KungAlpaca/HomeMadeUR10Gripper/docs/images/v2_iso_closed.png

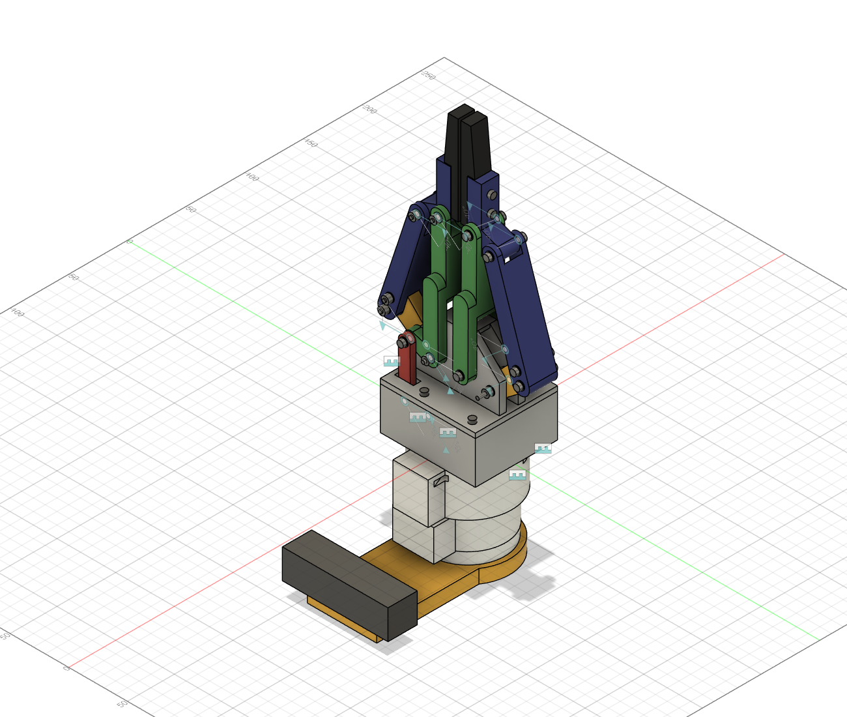
docs/images/v2_iso_closed.png
