KungAlpaca/HomeMadeUR10Gripper/docs/images/v2_iso_open.png

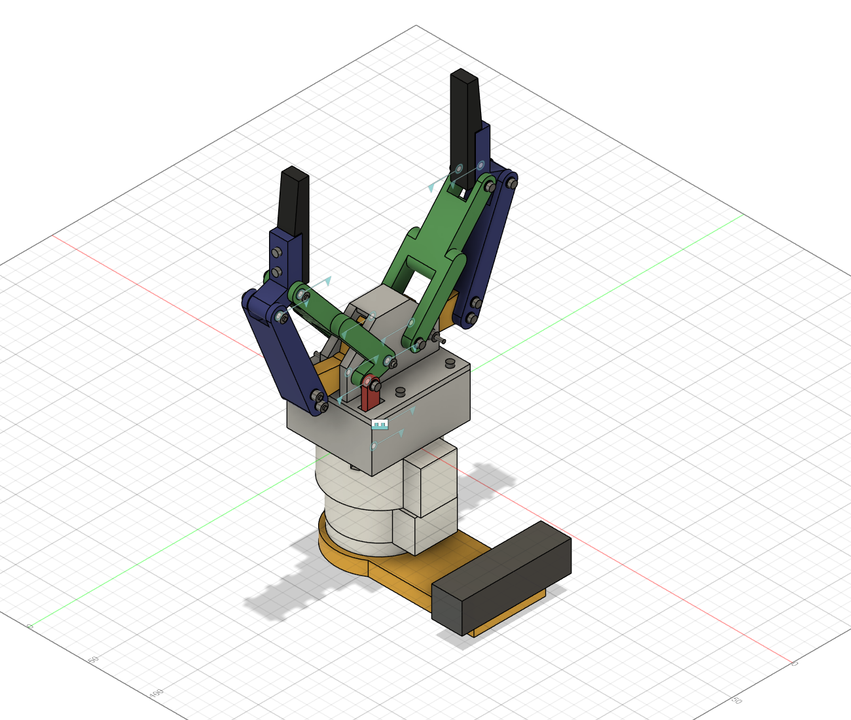
docs/images/v2_iso_open.png
