KungAlpaca/HomeMadeUR10Gripper/cad/HomeMade2F140_v2_assembly.step

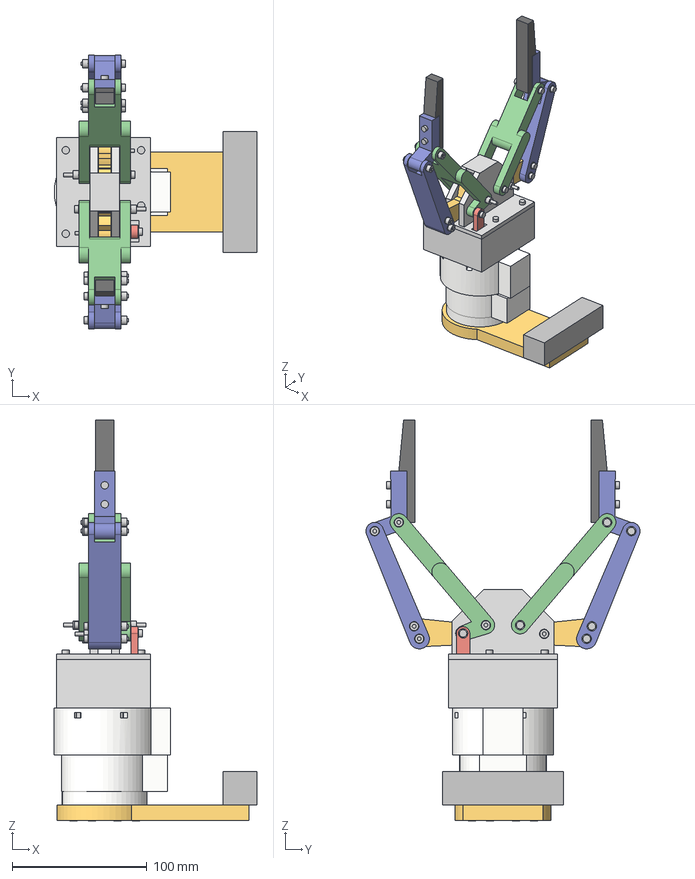
[picture p5: CAD file, 2026-10-15]
cad/HomeMade2F140_v2_assembly.step
150.3 x 203.5 x 297.7 mm
