KungAlpaca/HomeMadeUR10Gripper/print/parts/HomeMade2F140_SpacerB_x1.stl

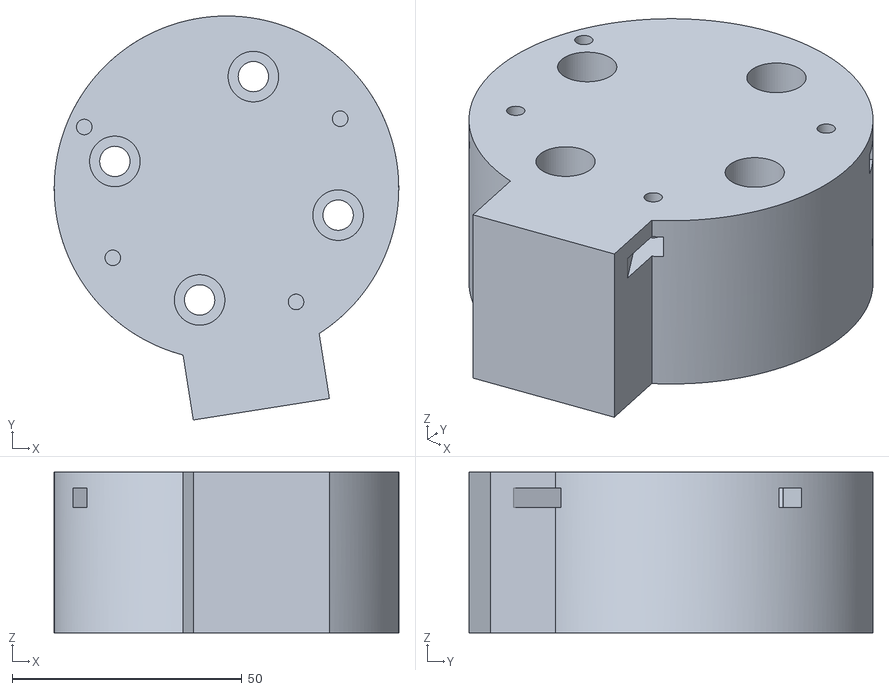
[picture p6: CAD file, 2026-10-15]
print/parts/HomeMade2F140_SpacerB_x1.stl
75.0 x 87.9 x 35.0
