KungAlpaca/HomeMadeUR10Gripper/print/plates/HomeMade2F140_plate1_250x250.stl

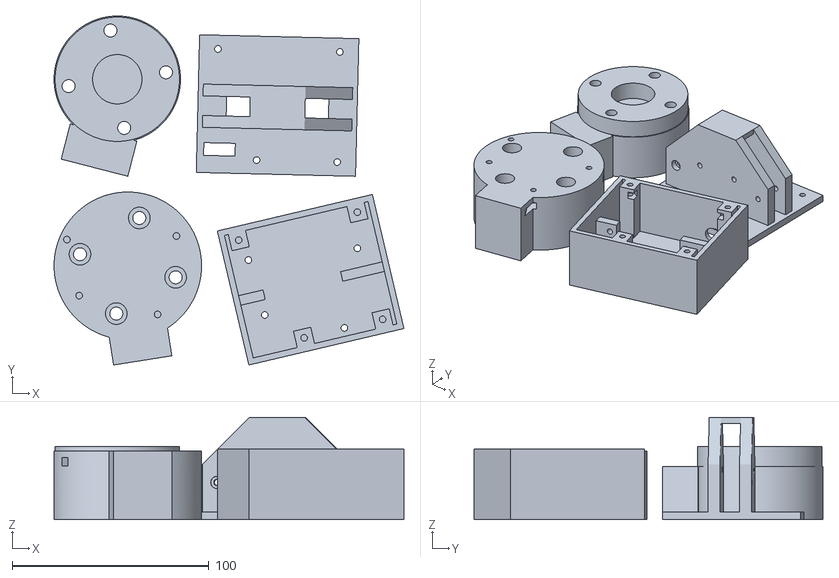
[picture p7: CAD file, 2026-10-15]
print/plates/HomeMade2F140_plate1_250x250.stl
177.9 x 177.4 x 52.0
