KungAlpaca/HomeMadeUR10Gripper/scripts/raw/SpacerB.stl

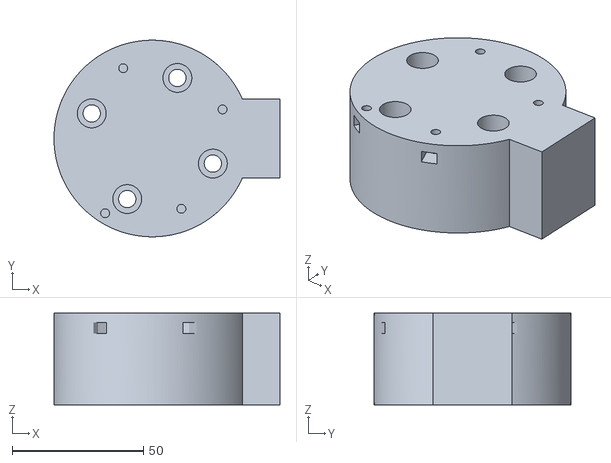
[picture p8: CAD file, 2026-10-15]
scripts/raw/SpacerB.stl
86.2 x 75.0 x 35.0
