KungAlpaca/HomeMadeUR10Gripper/print/parts/HomeMade2F140_Fingertip_x2.stl

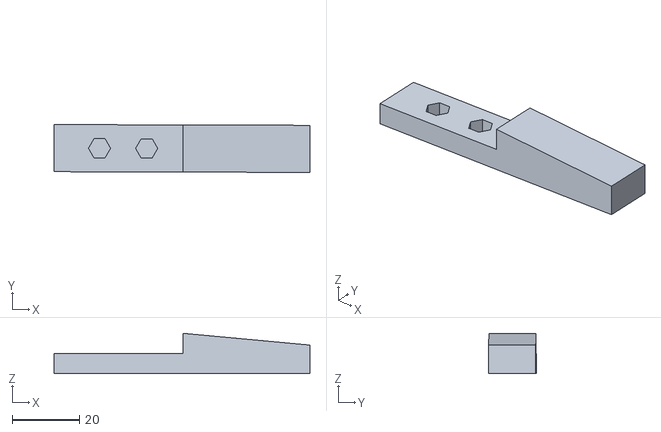
[picture p9: CAD file, 2026-10-15]
print/parts/HomeMade2F140_Fingertip_x2.stl
76.0 x 14.2 x 12.0
