KungAlpaca/HomeMadeUR10Gripper/print/plates/HomeMade2F140_print_set_17pcs.stl

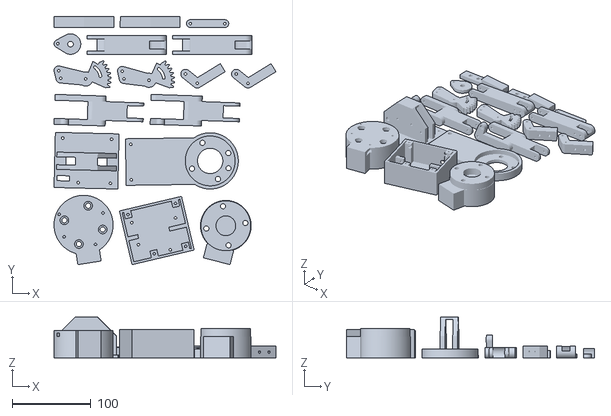
[picture p10: CAD file, 2026-10-15]
print/plates/HomeMade2F140_print_set_17pcs.stl
281.7 x 315.1 x 52.0
