KungAlpaca/HomeMadeUR10Gripper/scripts/raw/Crank.stl

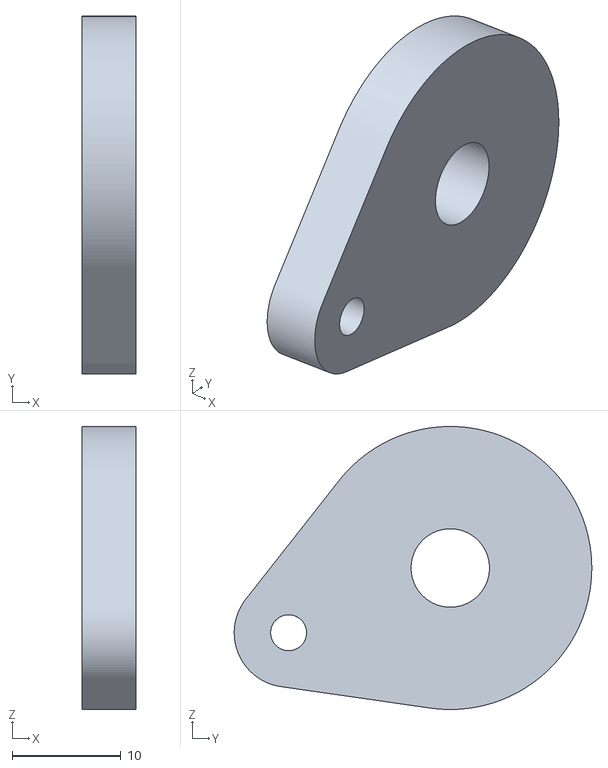
[picture p11: CAD file, 2026-10-15]
scripts/raw/Crank.stl
5.00 x 32.9 x 26.0
