KungAlpaca/HomeMadeUR10Gripper/print/parts/HomeMade2F140_CameraMount_x1.stl

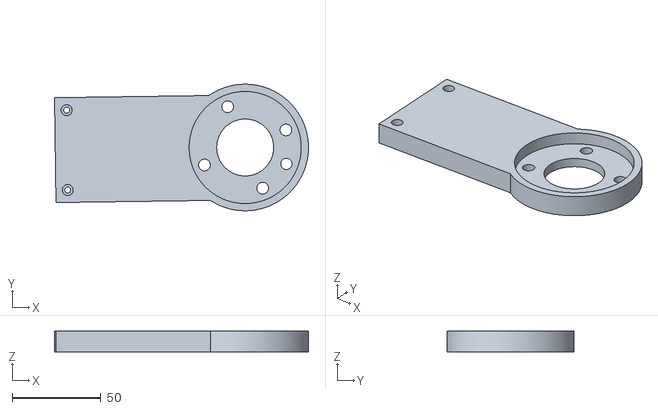
[picture p12: CAD file, 2026-10-15]
print/parts/HomeMade2F140_CameraMount_x1.stl
143.2 x 71.4 x 11.6
