KungAlpaca/HomeMadeUR10Gripper/print/plates/HomeMade2F140_plate2_250x250.stl

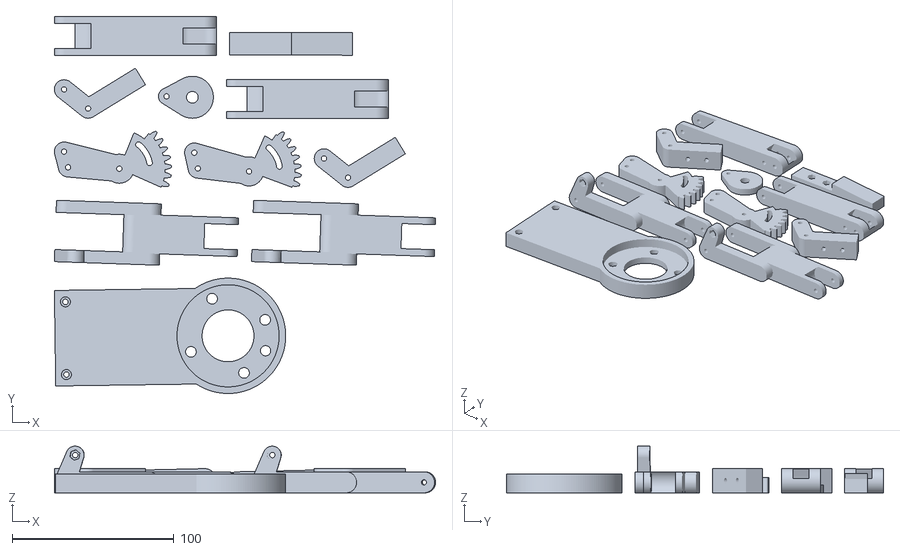
[picture p13: CAD file, 2026-10-15]
print/plates/HomeMade2F140_plate2_250x250.stl
236.0 x 233.3 x 28.9
