KungAlpaca/HomeMadeUR10Gripper/print/parts/HomeMade2F140_OuterFinger_x2.stl

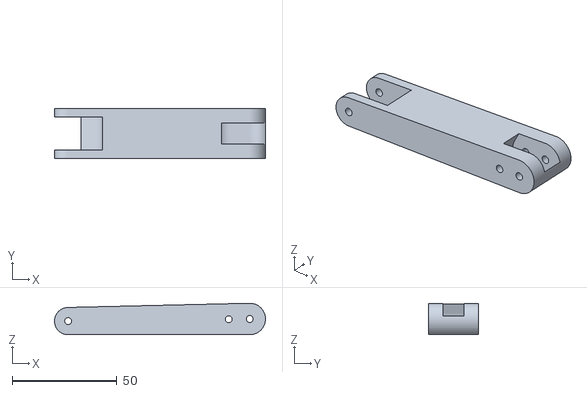
[picture p14: CAD file, 2026-10-15]
print/parts/HomeMade2F140_OuterFinger_x2.stl
100.5 x 24.0 x 15.0
