KungAlpaca/HomeMadeUR10Gripper/print/plates/HomeMade2F140_plate3_250x250.stl

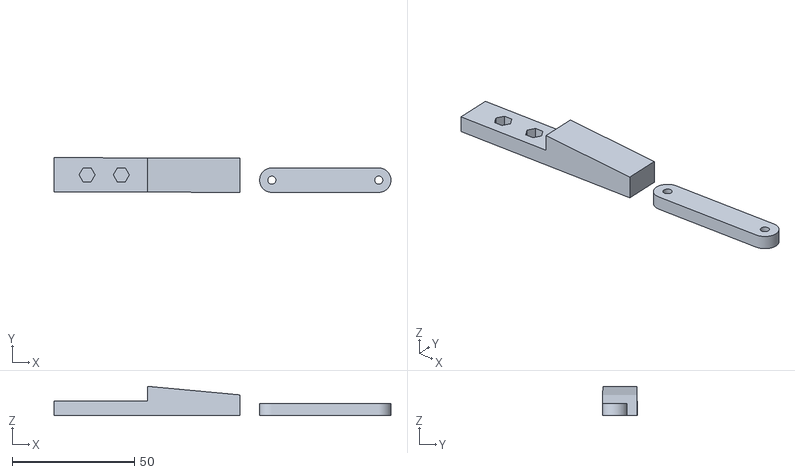
[picture p15: CAD file, 2026-10-15]
print/plates/HomeMade2F140_plate3_250x250.stl
137.8 x 14.2 x 12.0
