KungAlpaca/HomeMadeUR10Gripper/scripts/raw/SpacerA.stl

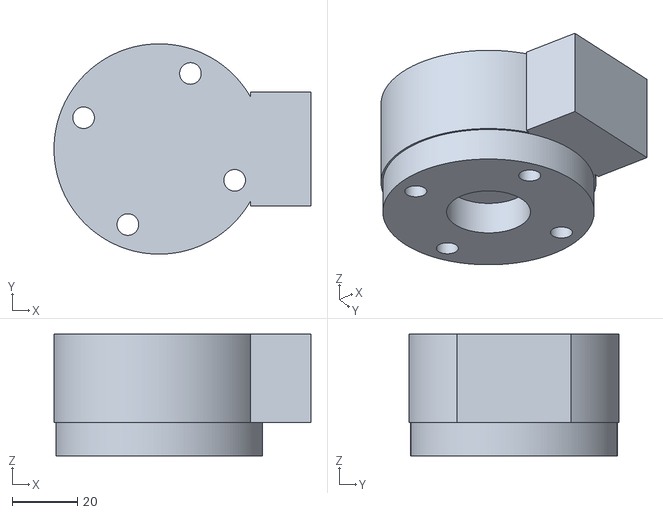
[picture p16: CAD file, 2026-10-15]
scripts/raw/SpacerA.stl
78.6 x 64.3 x 37.2
