KungAlpaca/HomeMadeUR10Gripper/print/parts/HomeMade2F140_SpacerA_x1.stl

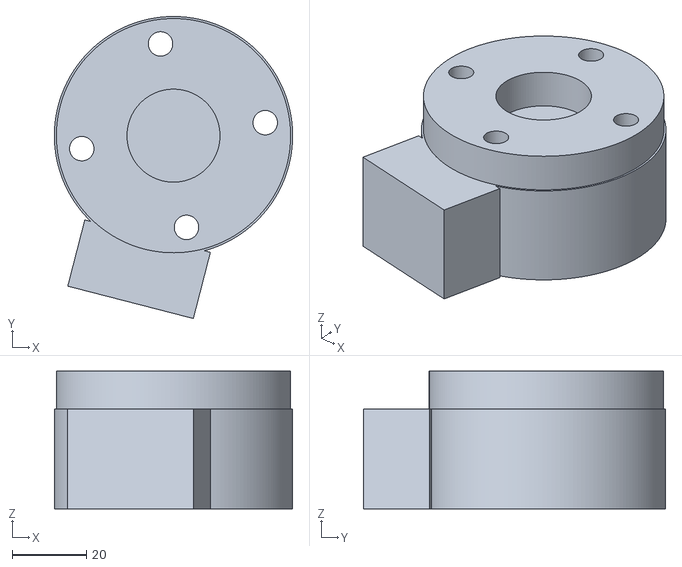
[picture p17: CAD file, 2026-10-15]
print/parts/HomeMade2F140_SpacerA_x1.stl
64.3 x 81.5 x 37.2
