KungAlpaca/HomeMadeUR10Gripper/scripts/raw/OuterKnuckle_L.stl

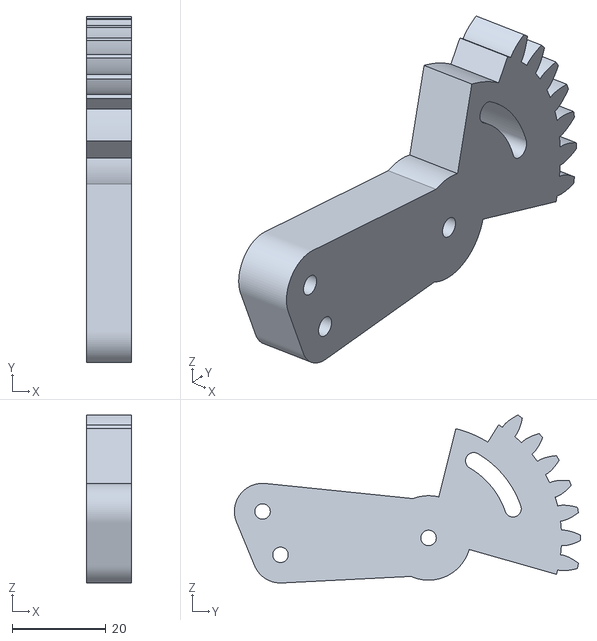
[picture p18: CAD file, 2026-10-15]
scripts/raw/OuterKnuckle_L.stl
9.50 x 73.8 x 35.8
