KungAlpaca/HomeMadeUR10Gripper/print/parts/HomeMade2F140_OuterKnuckle_R_x1.stl

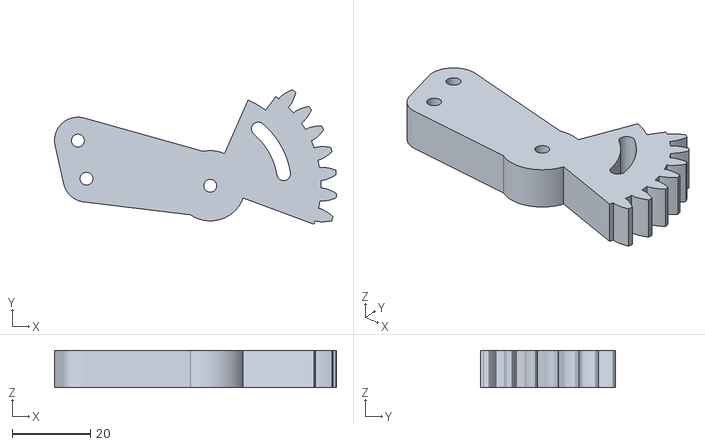
[picture p19: CAD file, 2026-10-15]
print/parts/HomeMade2F140_OuterKnuckle_R_x1.stl
72.2 x 34.5 x 9.50
