KungAlpaca/HomeMadeUR10Gripper/scripts/raw/HousingBox.stl

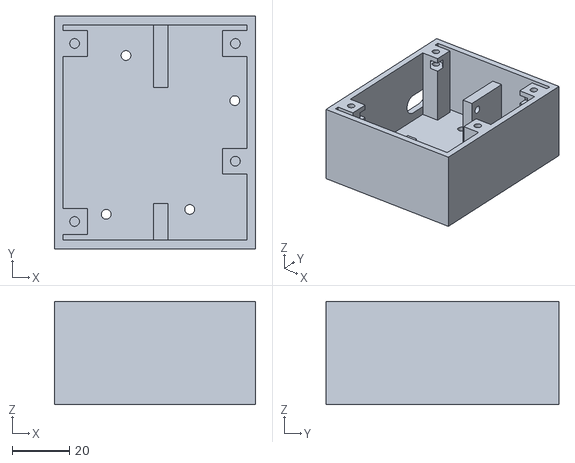
[picture p20: CAD file, 2026-10-15]
scripts/raw/HousingBox.stl
70.0 x 81.0 x 36.0
