KungAlpaca/HomeMadeUR10Gripper/print/parts/HomeMade2F140_Rod_x1.stl

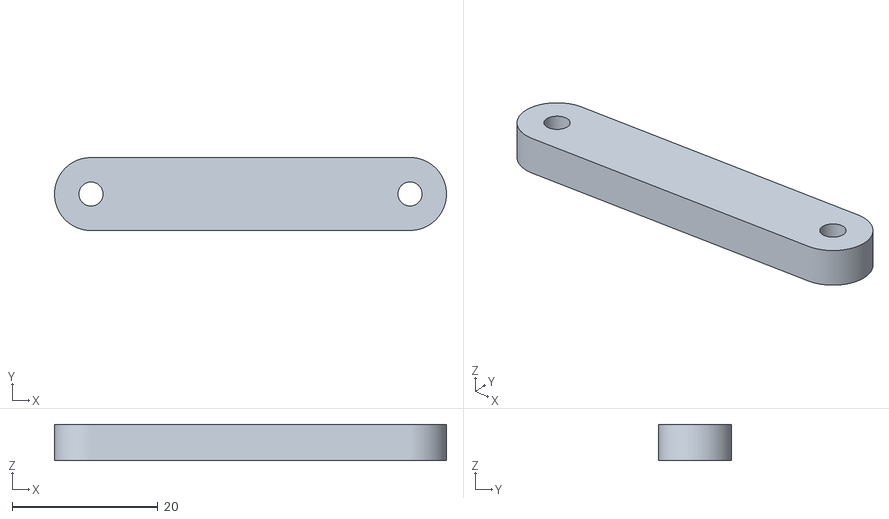
[picture p21: CAD file, 2026-10-15]
print/parts/HomeMade2F140_Rod_x1.stl
53.7 x 10.0 x 5.00
