KungAlpaca/HomeMadeUR10Gripper/scripts/raw/Servo_D5545GS.stl

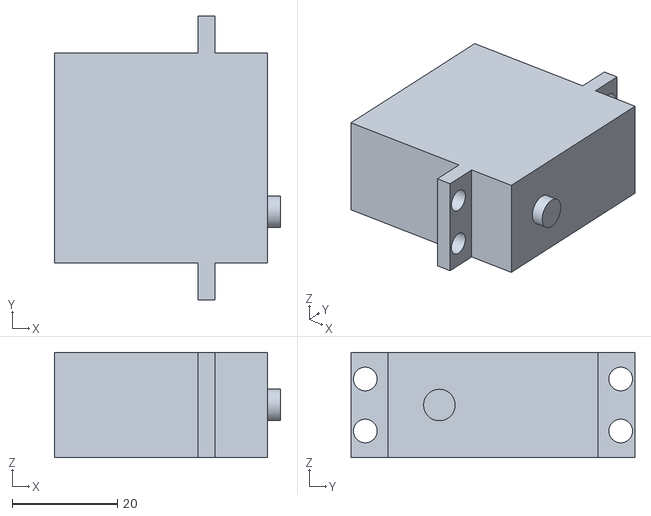
[picture p22: CAD file, 2026-10-15]
scripts/raw/Servo_D5545GS.stl
43.0 x 54.0 x 20.0
