KungAlpaca/HomeMadeUR10Gripper/print/parts/HomeMade2F140_InnerFinger_x2.stl

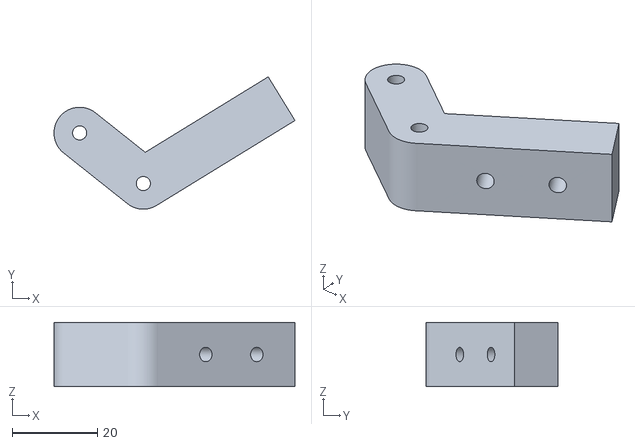
[picture p23: CAD file, 2026-10-15]
print/parts/HomeMade2F140_InnerFinger_x2.stl
56.4 x 31.0 x 15.0
