KungAlpaca/HomeMadeUR10Gripper/scripts/raw/InnerFinger.stl

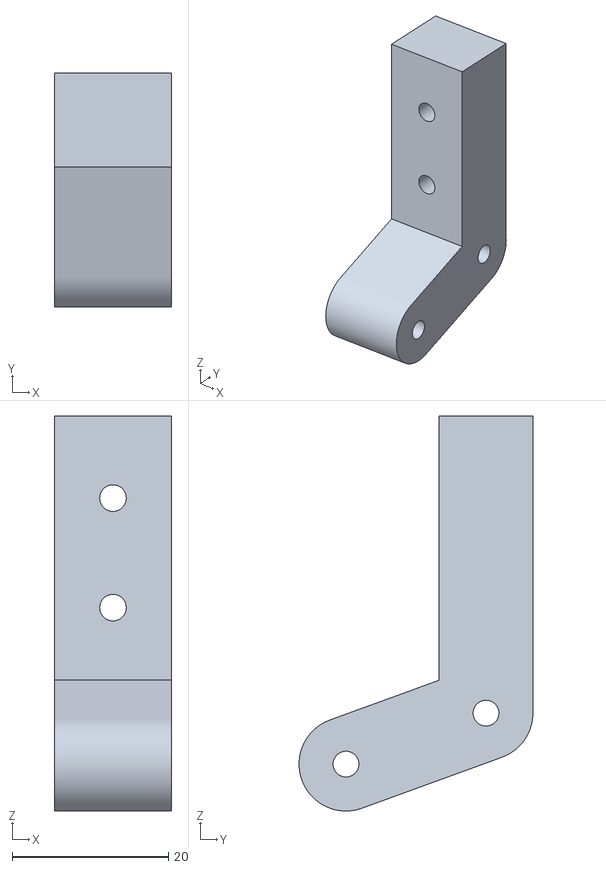
[picture p24: CAD file, 2026-10-15]
scripts/raw/InnerFinger.stl
15.0 x 29.9 x 50.5
