KungAlpaca/HomeMadeUR10Gripper/print/parts/HomeMade2F140_OuterKnuckle_L_x1.stl

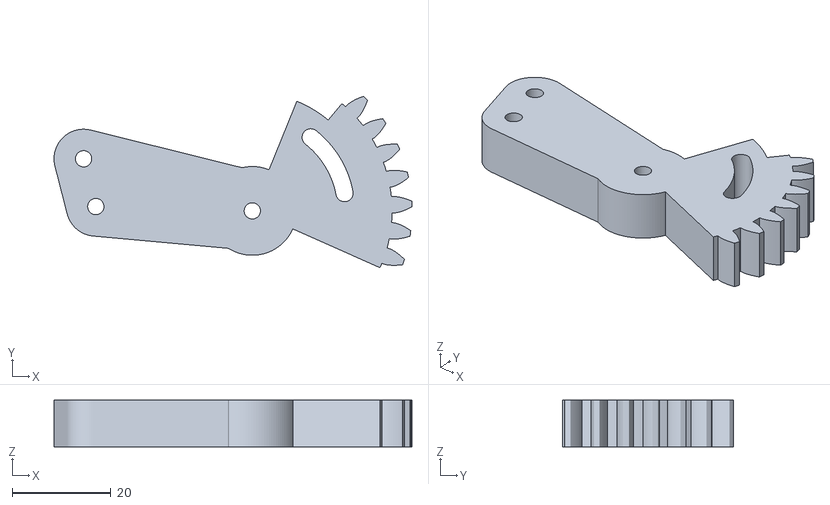
[picture p25: CAD file, 2026-10-15]
print/parts/HomeMade2F140_OuterKnuckle_L_x1.stl
72.6 x 34.8 x 9.50
