KungAlpaca/HomeMadeUR10Gripper/scripts/raw/OuterFinger.stl

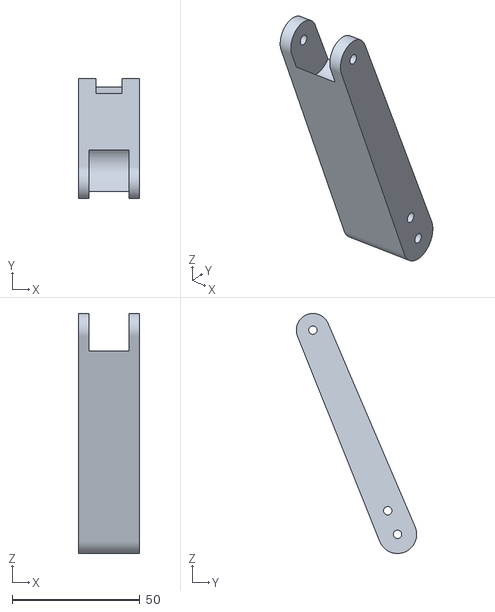
[picture p26: CAD file, 2026-10-15]
scripts/raw/OuterFinger.stl
24.0 x 47.1 x 93.9
