KungAlpaca/HomeMadeUR10Gripper/print/parts/HomeMade2F140_HousingBox_x1.stl

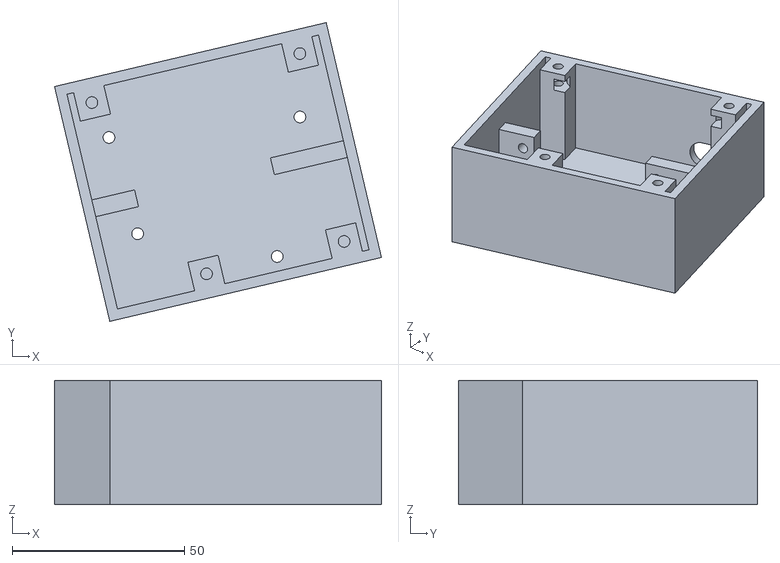
[picture p27: CAD file, 2026-10-15]
print/parts/HomeMade2F140_HousingBox_x1.stl
94.9 x 86.7 x 36.0
