KungAlpaca/HomeMadeUR10Gripper/print/parts/HomeMade2F140_Crank_x1.stl

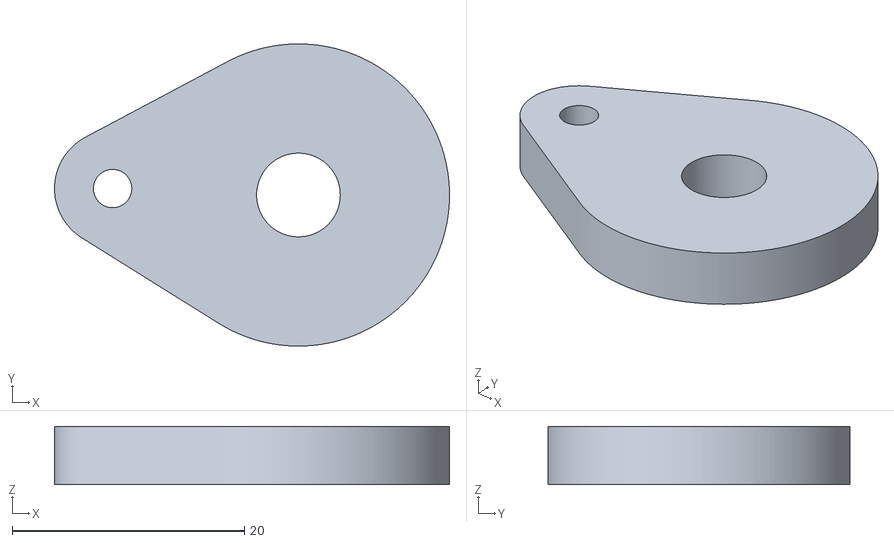
[picture p28: CAD file, 2026-10-15]
print/parts/HomeMade2F140_Crank_x1.stl
34.0 x 26.0 x 5.00
