KungAlpaca/HomeMadeUR10Gripper/print/parts/HomeMade2F140_Tower_x1.stl

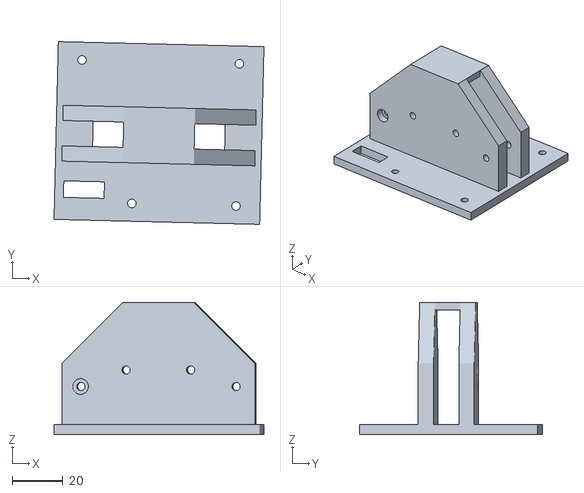
[picture p29: CAD file, 2026-10-15]
print/parts/HomeMade2F140_Tower_x1.stl
82.7 x 71.9 x 52.0
