KungAlpaca/HomeMadeUR10Gripper/scripts/raw/OuterKnuckle_R.stl

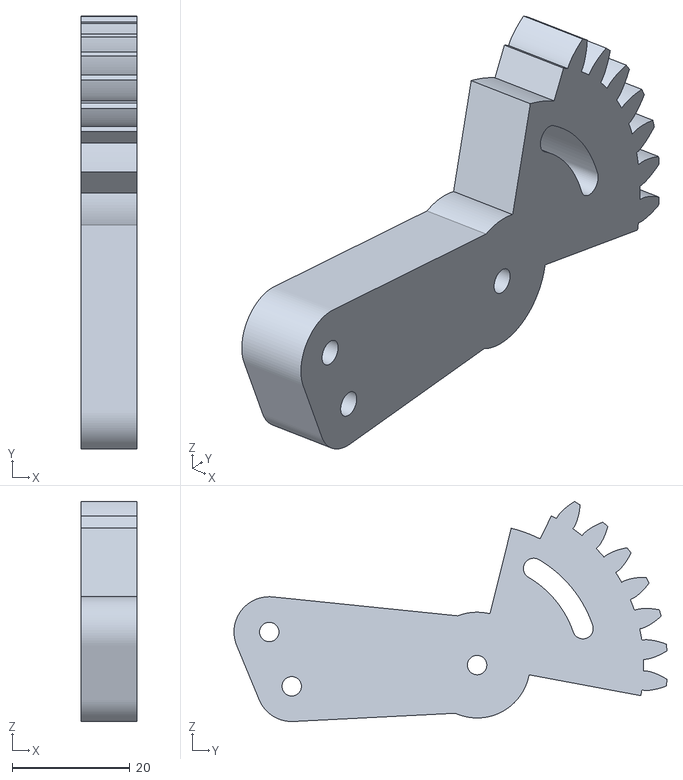
[picture p30: CAD file, 2026-10-15]
scripts/raw/OuterKnuckle_R.stl
9.50 x 73.7 x 37.4
