KungAlpaca/HomeMadeUR10Gripper/print/parts/HomeMade2F140_InnerKnuckle_x2.stl

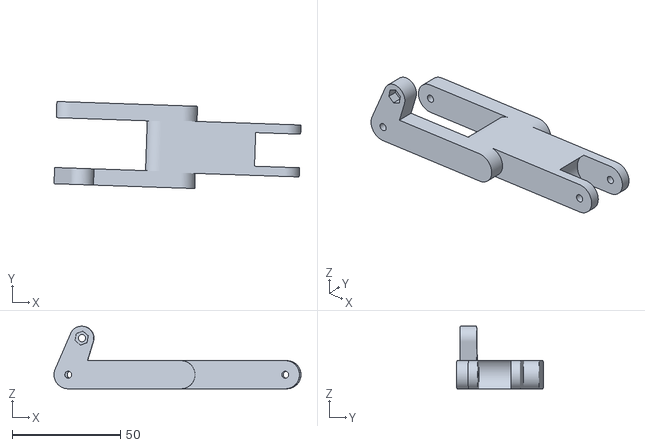
[picture p31: CAD file, 2026-10-15]
print/parts/HomeMade2F140_InnerKnuckle_x2.stl
114.0 x 40.2 x 28.9
