KungAlpaca/HomeMadeUR10Gripper/scripts/raw/Tower.stl

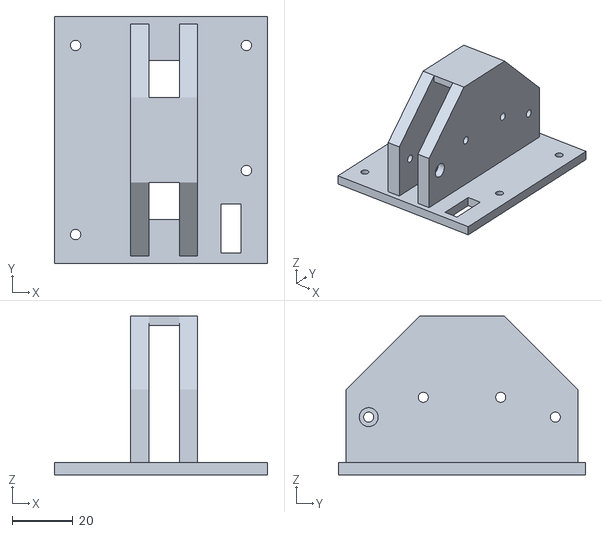
[picture p32: CAD file, 2026-10-15]
scripts/raw/Tower.stl
70.0 x 81.0 x 52.0
