KungAlpaca/HomeMadeUR10Gripper/scripts/raw/InnerKnuckle.stl

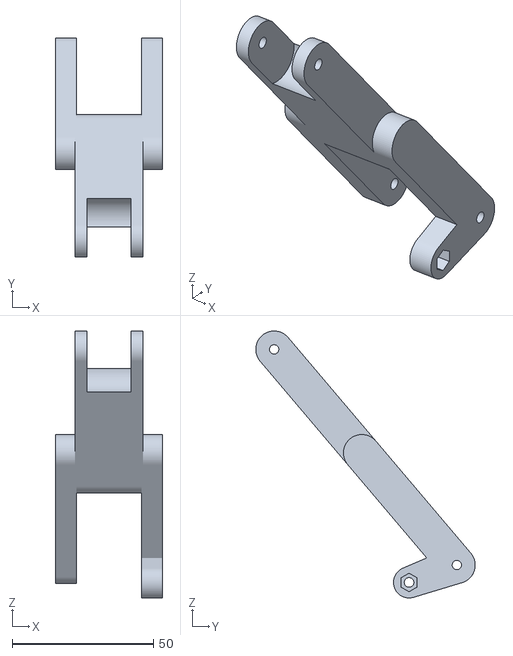
[picture p33: CAD file, 2026-10-15]
scripts/raw/InnerKnuckle.stl
38.0 x 77.6 x 94.5
