KungAlpaca/HomeMadeUR10Gripper/scripts/raw/RealSense_D435i_Ref.stl

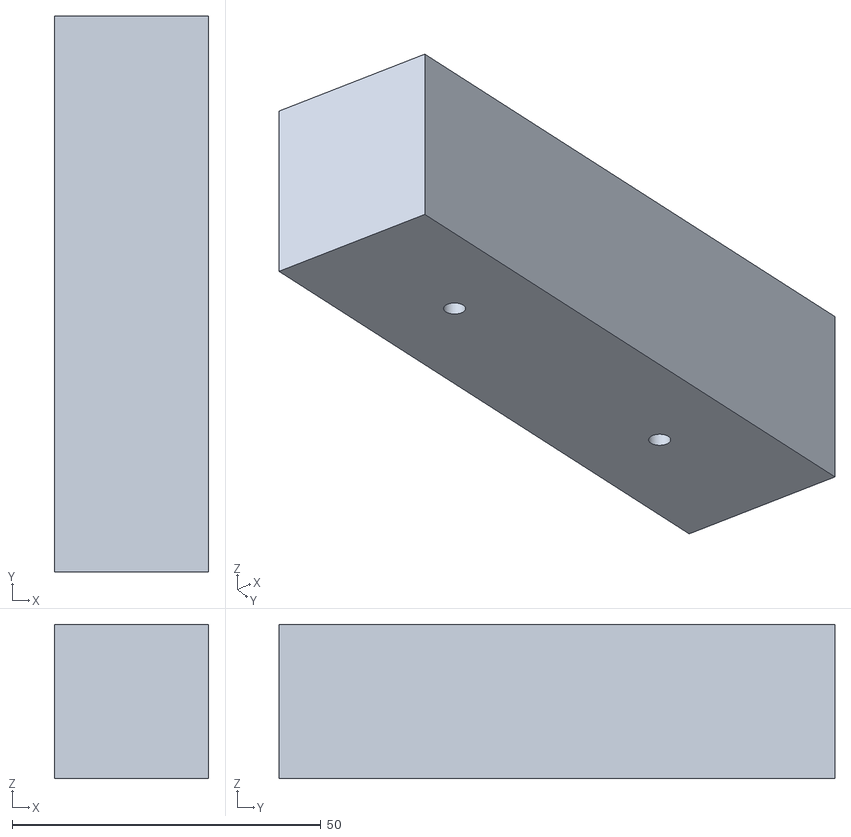
[picture p34: CAD file, 2026-10-15]
scripts/raw/RealSense_D435i_Ref.stl
25.0 x 90.0 x 25.0
