KungAlpaca/HomeMadeUR10Gripper/scripts/raw/ServoHorn_Ref.stl

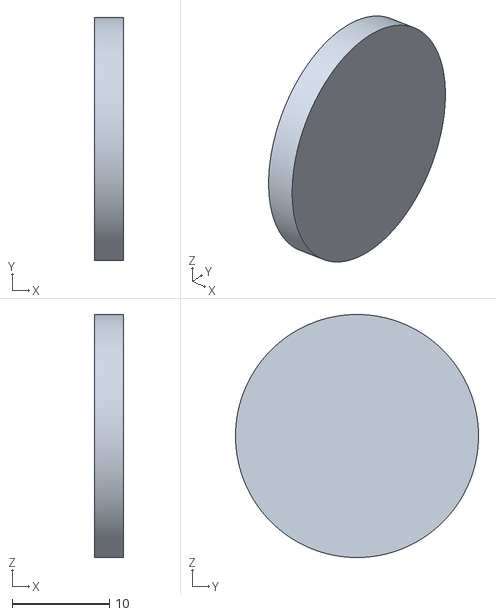
[picture p35: CAD file, 2026-10-15]
scripts/raw/ServoHorn_Ref.stl
3.00 x 25.0 x 25.0
