KungAlpaca/HomeMadeUR10Gripper/(list of files, cad)

Other CAD files:
scripts/raw/Fingertip.stl
scripts/raw/CameraMount.stl
scripts/raw/Rod.stl
cad/HomeMade2F140_v2.f3d
