KungAlpaca/HomeMadeUR10Gripper/docs/manual/HomeMade2F140_Manual_de_ensamble_ES.pdf

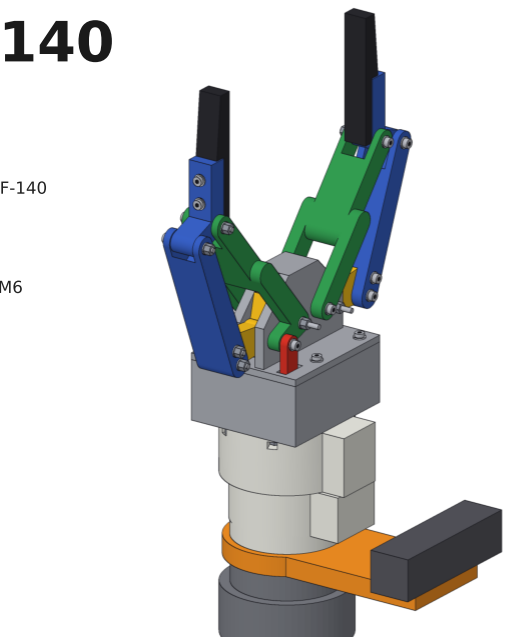
[picture p39: figure]

# HomeMade2F140

# Manual de ensamble

## Gripper de 2 dedos con la cinematica del Robotiq 2F-140

## Servo DFRobot SER0062 (D5545GS) - version v2

## 17 piezas impresas - 36 tornillos M3 - 4 tornillos M6

## 30 tuercas M3 nyloc - 50 arandelas M3

Herramientas: llave allen 2,5 mm y 5 mm,

llave de 5,5 mm para tuercas M3.

## Pasos 1-12: muneca y caja con el servo

## Pasos 13-23: torre con los dedos (en la mesa) Pasos 24-26: union final

# Inventario de piezas

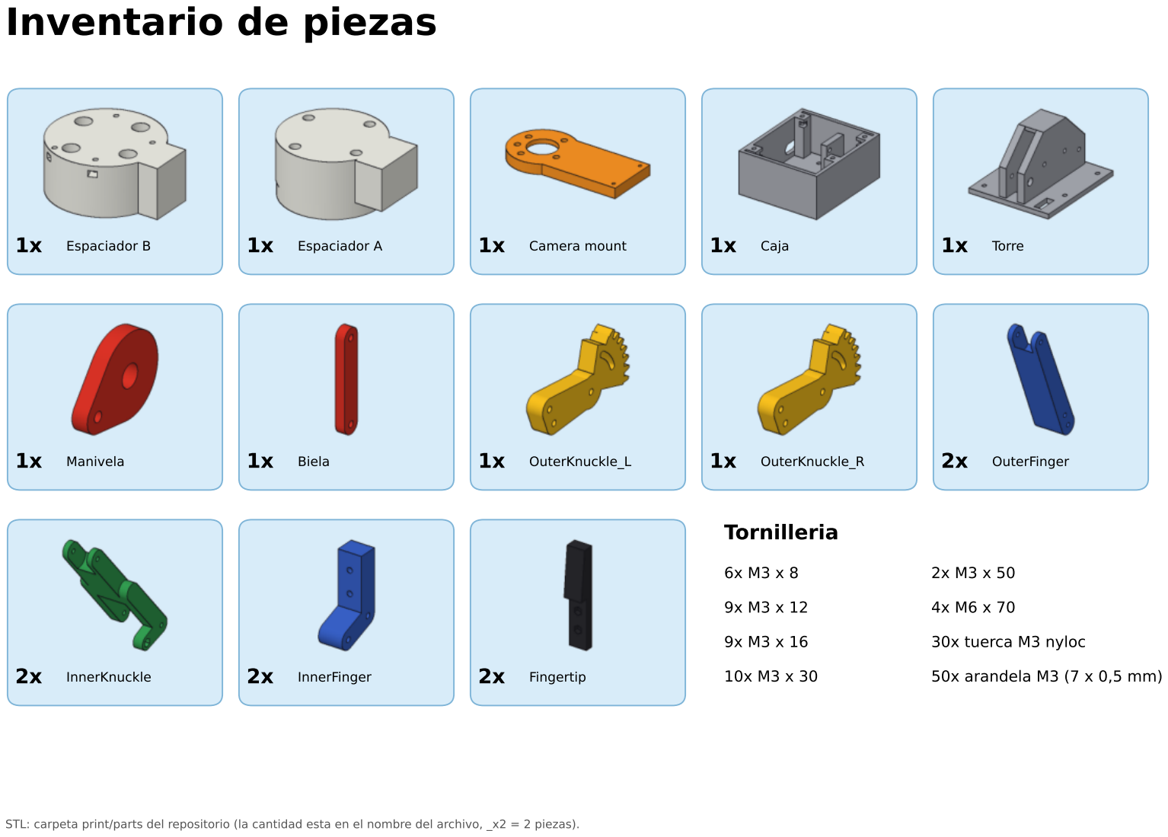
[picture p40: page 2]

## Tornilleria

6x M3 x 8

9x M3 x 12

9x M3 x 16

10x M3 x 30

2x M3 x 50

4x M6 x 70

30x tuerca M3 nyloc

50x arandela M3 (7 x 0,5 mm)

STL: carpeta print/parts del repositorio (la cantidad esta en el nombre del archivo, _x2 = 2 piezas).

1x | Espaciador B | 1x | Espaciador A | 1x | Camera mount | 1x | Caja | 1x | Torre
1x | Manivela | 1x | Biela | 1x | OuterKnuckle_L | 1x | OuterKnuckle_R | 2x | OuterFinger
2x | InnerKnuckle | 2x | InnerFinger | 2x | Fingertip

1

## Tuercas en el espaciador B

- Mete una tuerca nyloc en cada ranura lateral hasta que quede centrada con el agujero.
HomeMade2F140 v2 | paso 1/26

1x

Espaciador B

4x

Tuerca M3 nyloc

2

## Camera mount sobre la brida del robot

- El brazo de la camara apunta hacia +X (el lado donde ira la biela roja).
- Opcional: pasador de 6 mm en el agujero de centrado.

1x

Camera mount

3

## Espaciadores A y B

- El bloque saliente de ambos espaciadores va hacia el brazo de la camara.

1x

Espaciador A

1x

Espaciador B (paso 1)

4

## 4 tornillos M6 a la brida

- Aprieta en cruz. La cabeza queda hundida en el espaciador B.

4x

M6 x 70

5

## Camara RealSense D435i

- Los 2 tornillos entran por debajo del camera mount.

1x

RealSense D435i

2x

M3 x 8

6

## Tuercas en la caja

- Una tuerca nyloc en cada columna de las esquinas, por la ranura interior.

1x

Caja

4x

Tuerca M3 nyloc

7

## Caja sobre el espaciador B

- La pared con el hueco de cable (-X) va del lado opuesto a la camara.

1x

Caja (paso 6)

8

## Tornillos de la caja

- Desde dentro de la caja, antes de meter el servo.

4x

M3 x 12

4x

Arandela M3

9

## Manivela + biela (en la mesa)

- Aprieta la tuerca solo hasta quitar el juego: la biela debe girar libre.

1x

Manivela

1x

Biela

1x

M3 x 16

2x

Arandela M3

1x

Tuerca M3 nyloc

10

## Horn y manivela al servo

- 1) Taladra la manivela usando el horn metalico como plantilla.
- 2) Lleva el servo a su centro (1500 us).
- 3) Monta el horn con la manivela hacia -Y (como en el dibujo) y la biela vertical.

1x

Servo D5545GS

1x

Horn metalico

1x

Manivela + biela (paso 9)

11

## Servo dentro de la caja

- Baja el servo desde arriba: las orejas apoyan en la mampara interior.

1x

Servo + manivela (paso 10)

12

## Tornillos del servo

- Cabeza del lado de la mampara (+X), tuerca del lado de la oreja del servo.

4x

M3 x 16

8x

Arandela M3

4x

Tuerca M3 nyloc

13

## Outer knuckles en la torre (en la mesa)

- OuterKnuckle_L va del lado -Y (lado de la biela). L y R NO son intercambiables.
- Engrana ambos con los dedos en posicion abierta (simetricos).

1x

Torre

1x

OuterKnuckle_L

1x

OuterKnuckle_R

14

## Pivotes de los outer knuckles

- Izquierdo: cabeza hundida en la cara +X. Derecho: cabeza hundida en la cara -X.

2x

M3 x 30

2x

Arandela M3

2x

Tuerca M3 nyloc

15

## Tuerca en la oreja (en la mesa)

- Solo el inner knuckle que va del lado -Y usa la oreja. Mete la tuerca hasta el fondo del hexagono.

1x

InnerKnuckle

1x

Tuerca M3 nyloc

16

## Inner knuckles

- Los brazos abrazan la torre por fuera. La oreja con tuerca queda del lado -Y, cara +X.

2x

InnerKnuckle

17

## Pivotes de los inner knuckles

- Orden: brazo - arandela - pared - ranura del engrane - pared - arandela - brazo.

2x

M3 x 50

8x

Arandela M3

2x

Tuerca M3 nyloc

18

## Outer fingers

- La horquilla del outer finger abraza el

brazo amarillo.

2x

OuterFinger

19

## Union outer knuckle - outer finger

- 2 tornillos por lado: esta union es rigida, aprieta firme.

4x

M3 x 30

8x

Arandela M3

4x

Tuerca M3 nyloc

20

## Inner fingers

- Entran en las horquillas del outer finger

(azul) y del inner knuckle (verde).

2x

InnerFinger

21

## Pivotes de los inner fingers

- Aprieta hasta quitar el juego; los dedos deben moverse suaves.

4x

M3 x 30

8x

Arandela M3

4x

Tuerca M3 nyloc

22

## Tuercas en las puntas (en la mesa)

- 2 tuercas en los hexagonos de la cara trasera de cada punta.
- Repite con la otra punta.

x2

1x

Fingertip

2x

Tuerca M3 nyloc

23

## Puntas en los inner fingers

- Tornillos desde la cara exterior del inner finger.

2x

Fingertip

4x

M3 x 16

4x

Arandela M3

24

## Torre sobre la caja

- Pasa la biela roja por la ranura de la placa de la torre.

1x

Torre con dedos (pasos 13-23)

25

## Tornillos de la torre

4x

M3 x 12

4x

Arandela M3

26

## Biela a la oreja

- Mueve los dedos a mano hasta alinear el agujero de la biela con la tuerca de la oreja.
- Apretar solo hasta quitar el juego.

1x

M3 x 12

2x

Arandela M3

# Listo!

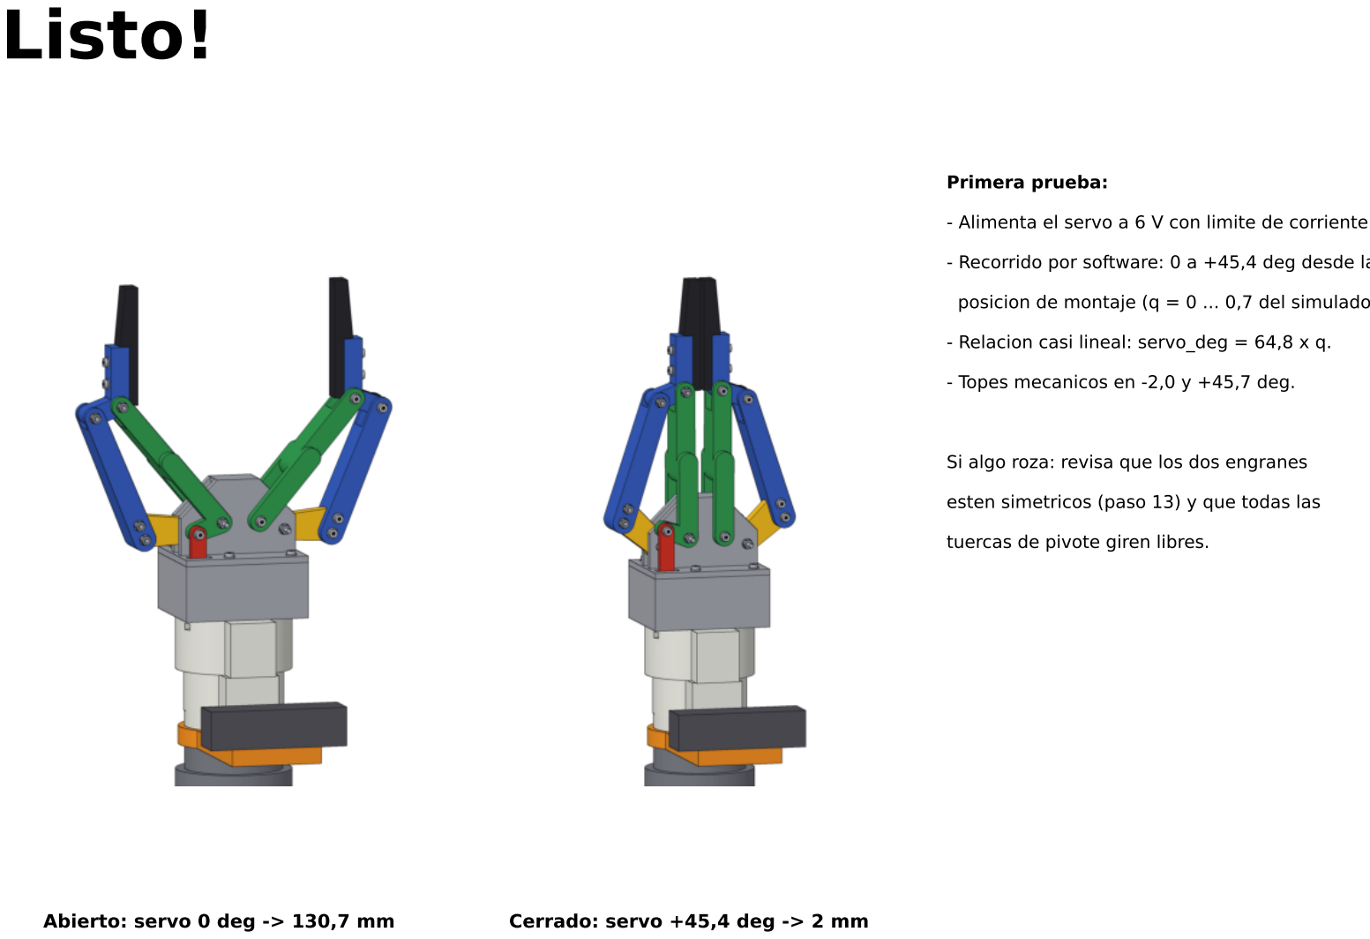
[picture p41: page 29]

Abierto: servo 0 deg -> 130,7 mm | Cerrado: servo +45,4 deg -> 2 mm

Primera prueba:

- Alimenta el servo a 6 V con limite de corriente.
- Recorrido por software: 0 a +45,4 deg desde la

posicion de montaje (q = 0 ... 0,7 del simulador).

- Relacion casi lineal: servo_deg = 64,8 x q.
- Topes mecanicos en -2,0 y +45,7 deg.

Si algo roza: revisa que los dos engranes

esten simetricos (paso 13) y que todas las

tuercas de pivote giren libres.
