KungAlpaca/HomeMadeUR10Gripper/scripts/manual_i18n.py

"""English strings for manual.py (keys are the Spanish originals)."""
EN = {
    'Tuercas en el espaciador B': 'Nuts into spacer B',
    'Mete una tuerca nyloc en cada ranura lateral hasta que quede centrada con el agujero.':
        'Push one nyloc nut into each side slot until it is centred on the hole.',
    'Camera mount sobre la brida del robot': 'Camera mount onto the robot flange',
    'El brazo de la camara apunta hacia +X (el lado donde ira la biela roja).':
        'The camera arm points to +X (the side where the red rod will be).',
    'Opcional: pasador de 6 mm en el agujero de centrado.': 'Optional: 6 mm dowel pin in the centring hole.',
    'Espaciadores A y B': 'Spacers A and B',
    'El bloque saliente de ambos espaciadores va hacia el brazo de la camara.':
        'The side block of both spacers faces the camera arm.',
    'Espaciador B (paso 1)': 'Spacer B (step 1)',
    '4 tornillos M6 a la brida': '4 M6 bolts into the flange',
    'Aprieta en cruz. La cabeza queda hundida en el espaciador B.': 'Tighten crosswise. The heads sit recessed in spacer B.',
    'Camara RealSense D435i': 'RealSense D435i camera',
    'Los 2 tornillos entran por debajo del camera mount.': 'Both screws go in from under the camera mount.',
    'Tuercas en la caja': 'Nuts into the housing box',
    'Una tuerca nyloc en cada columna de las esquinas, por la ranura interior.':
        'One nyloc nut in each corner column, through the inner slot.',
    'Caja sobre el espaciador B': 'Housing box onto spacer B',
    'La pared con el hueco de cable (-X) va del lado opuesto a la camara.':
        'The wall with the cable opening (-X) faces away from the camera.',
    'Caja (paso 6)': 'Housing box (step 6)',
    'Tornillos de la caja': 'Housing box screws',
    'Desde dentro de la caja, antes de meter el servo.': 'From inside the box, before fitting the servo.',
    'Manivela + biela (en la mesa)': 'Crank + rod (on the bench)',
    'Aprieta la tuerca solo hasta quitar el juego: la biela debe girar libre.':
        'Tighten the nut only until the play is gone: the rod must turn freely.',
    'Horn y manivela al servo': 'Horn and crank onto the servo',
    '1) Taladra la manivela usando el horn metalico como plantilla.': '1) Drill the crank using the metal horn as a template.',
    '2) Lleva el servo a su centro (1500 us).': '2) Move the servo to its centre (1500 us).',
    '3) Monta el horn con la manivela hacia -Y (como en el dibujo) y la biela vertical.':
        '3) Fit the horn with the crank pointing to -Y (as drawn) and the rod vertical.',
    'Manivela + biela (paso 9)': 'Crank + rod (step 9)',
    'Servo dentro de la caja': 'Servo into the housing box',
    'Baja el servo desde arriba: las orejas apoyan en la mampara interior.':
        'Lower the servo from above: its ears rest on the inner bulkhead.',
    'Servo + manivela (paso 10)': 'Servo + crank (step 10)',
    'Tornillos del servo': 'Servo screws',
    'Cabeza del lado de la mampara (+X), tuerca del lado de la oreja del servo.':
        'Head on the bulkhead side (+X), nut on the servo-ear side.',
    'Outer knuckles en la torre (en la mesa)': 'Outer knuckles into the tower (on the bench)',
    'OuterKnuckle_L va del lado -Y (lado de la biela). L y R NO son intercambiables.':
        'OuterKnuckle_L goes on the -Y side (rod side). L and R are NOT interchangeable.',
    'Engrana ambos con los dedos en posicion abierta (simetricos).': 'Mesh both with the fingers open (symmetric).',
    'Pivotes de los outer knuckles': 'Outer knuckle pivots',
    'Izquierdo: cabeza hundida en la cara +X. Derecho: cabeza hundida en la cara -X.':
        'Left: head recessed in the +X face. Right: head recessed in the -X face.',
    'Tuerca en la oreja (en la mesa)': 'Nut into the ear (on the bench)',
    'Solo el inner knuckle que va del lado -Y usa la oreja. Mete la tuerca hasta el fondo del hexagono.':
        'Only the inner knuckle on the -Y side uses its ear. Push the nut to the bottom of the hex pocket.',
    'Los brazos abrazan la torre por fuera. La oreja con tuerca queda del lado -Y, cara +X.':
        'The prongs straddle the tower. The ear with the nut ends up on the -Y side, +X face.',
    'Pivotes de los inner knuckles': 'Inner knuckle pivots',
    'Orden: brazo - arandela - pared - ranura del engrane - pared - arandela - brazo.':
        'Order: prong - washer - wall - gear slot - wall - washer - prong.',
    'La horquilla del outer finger abraza el brazo amarillo.': 'The outer-finger fork straddles the yellow arm.',
    'Union outer knuckle - outer finger': 'Outer knuckle - outer finger joint',
    '2 tornillos por lado: esta union es rigida, aprieta firme.': '2 bolts per side: this joint is rigid, tighten firmly.',
    'Entran en las horquillas del outer finger (azul) y del inner knuckle (verde).':
        'They slide into the forks of the outer finger (blue) and the inner knuckle (green).',
    'Pivotes de los inner fingers': 'Inner finger pivots',
    'Aprieta hasta quitar el juego; los dedos deben moverse suaves.':
        'Tighten until the play is gone; the fingers must move smoothly.',
    'Tuercas en las puntas (en la mesa)': 'Nuts into the fingertips (on the bench)',
    '2 tuercas en los hexagonos de la cara trasera de cada punta.': '2 nuts in the hex pockets on the back of each fingertip.',
    'Repite con la otra punta.': 'Repeat with the other fingertip.',
    'Puntas en los inner fingers': 'Fingertips onto the inner fingers',
    'Tornillos desde la cara exterior del inner finger.': 'Screws go in from the outer face of the inner finger.',
    'Torre sobre la caja': 'Tower onto the housing box',
    'Pasa la biela roja por la ranura de la placa de la torre.': 'Pass the red rod through the slot in the tower plate.',
    'Torre con dedos (pasos 13-23)': 'Tower with fingers (steps 13-23)',
    'Tornillos de la torre': 'Tower screws',
    'Biela a la oreja': 'Rod to the ear',
    'Mueve los dedos a mano hasta alinear el agujero de la biela con la tuerca de la oreja.':
        'Move the fingers by hand until the rod hole lines up with the ear nut.',
    'Apretar solo hasta quitar el juego.': 'Tighten only until the play is gone.',
    # part names
    'Torre': 'Tower', 'Caja': 'Housing box', 'Espaciador A': 'Spacer A', 'Espaciador B': 'Spacer B',
    'Horn metalico': 'Metal horn', 'Manivela': 'Crank', 'Biela': 'Rod', 'Brida UR': 'UR flange',
    'Tuerca M3 nyloc': 'M3 nyloc nut', 'Arandela M3': 'M3 washer',
    # pages
    'paso': 'step', 'Manual de ensamble': 'Assembly manual',
    'Gripper de 2 dedos con la cinematica del Robotiq 2F-140': '2-finger gripper with the Robotiq 2F-140 kinematics',
    'Servo DFRobot SER0062 (D5545GS)  -  version v2': 'DFRobot SER0062 (D5545GS) servo  -  version v2',
    '17 piezas impresas  -  36 tornillos M3  -  4 tornillos M6': '17 printed parts  -  36 M3 screws  -  4 M6 bolts',
    '30 tuercas M3 nyloc  -  50 arandelas M3': '30 M3 nyloc nuts  -  50 M3 washers',
    'Herramientas: llave allen 2,5 mm y 5 mm,': 'Tools: 2.5 mm and 5 mm hex keys,',
    'llave de 5,5 mm para tuercas M3.': '5.5 mm wrench for the M3 nuts.',
    'Pasos 1-12: muneca y caja con el servo': 'Steps 1-12: wrist stack and housing with the servo',
    'Pasos 13-23: torre con los dedos (en la mesa)': 'Steps 13-23: tower with the fingers (on the bench)',
    'Pasos 24-26: union final': 'Steps 24-26: final assembly',
    'Inventario de piezas': 'Parts inventory', 'Tornilleria': 'Hardware',
    '30x tuerca M3 nyloc': '30x M3 nyloc nut', '50x arandela M3 (7 x 0,5 mm)': '50x M3 washer (7 x 0.5 mm)',
    'STL: carpeta print/parts del repositorio (la cantidad esta en el nombre del archivo, _x2 = 2 piezas).':
        'STL: repository folder print/parts (the quantity is in the file name, _x2 = 2 pieces).',
    'Listo!': 'Done!',
    'Abierto: servo 0 deg -> 130,7 mm': 'Open: servo 0 deg -> 130.7 mm',
    'Cerrado: servo +45,4 deg -> 2 mm': 'Closed: servo +45.4 deg -> 2 mm',
    'Primera prueba:': 'First test:',
    '- Alimenta el servo a 6 V con limite de corriente.': '- Power the servo at 6 V with a current limit.',
    '- Recorrido por software: 0 a +45,4 deg desde la': '- Software range: 0 to +45.4 deg from the',
    '  posicion de montaje (q = 0 ... 0,7 del simulador).': '  assembly position (q = 0 ... 0.7 in the simulator).',
    '- Relacion casi lineal: servo_deg = 64,8 x q.': '- Nearly linear: servo_deg = 64.8 x q.',
    '- Topes mecanicos en -2,0 y +45,7 deg.': '- Mechanical stops at -2.0 and +45.7 deg.',
    'Si algo roza: revisa que los dos engranes': 'If something rubs: check that both gears',
    'esten simetricos (paso 13) y que todas las': 'are symmetric (step 13) and that every',
    'tuercas de pivote giren libres.': 'pivot turns freely.',
    'HomeMade2F140 v2 - Manual de ensamble': 'HomeMade2F140 v2 - Assembly manual',
}
