KungAlpaca/HomeMadeUR10Gripper/(commit log)

2026-10-15 HomeMade2F140 v2: open-source printable UR10e gripper (CERN-OHL-P-2.0 / MIT)
    [CameraMount.stl, Crank.stl, Fingertip.stl, HomeMade2F140_CameraMount_x1.stl, HomeMade2F140_Crank_x1.stl, HomeMade2F140_Fingertip_x2.stl, HomeMade2F140_HousingBox_x1.stl, HomeMade2F140_InnerFinger_x2.stl]
2026-10-15 Use M3x50 inner pivots and M6x70 flange bolts (deeper SpacerB counterbore)
    [HomeMade2F140_SpacerB_x1.stl, HomeMade2F140_plate1_250x250.stl, HomeMade2F140_print_set_17pcs.stl, HomeMade2F140_v2.f3d, HomeMade2F140_v2_assembly.step, SpacerB.stl]
